cyborg-x1/Mantis-Microscope-Light/README.md

Mantis-Microscope-Light
=======================

A microscope light for mantis microscopes, includes Schematics, Linux Control Software and AVR Software
