cyborg-x1/Mantis-Microscope-Light/kicad/output.pdf

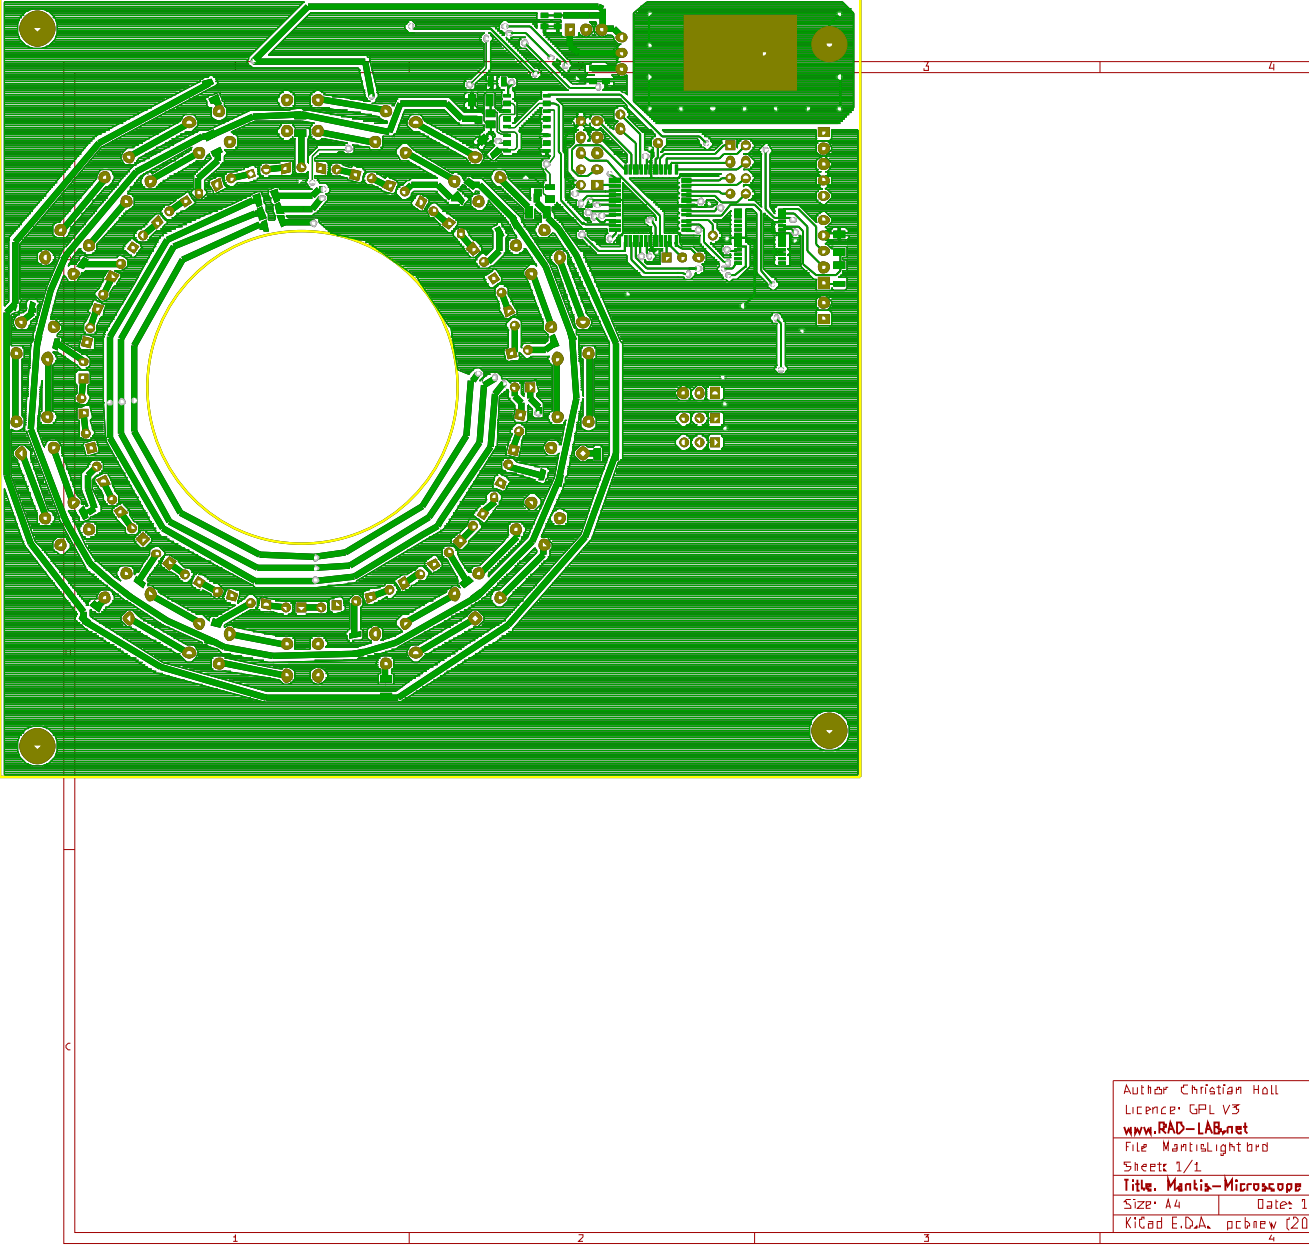
[picture p1: page 1]

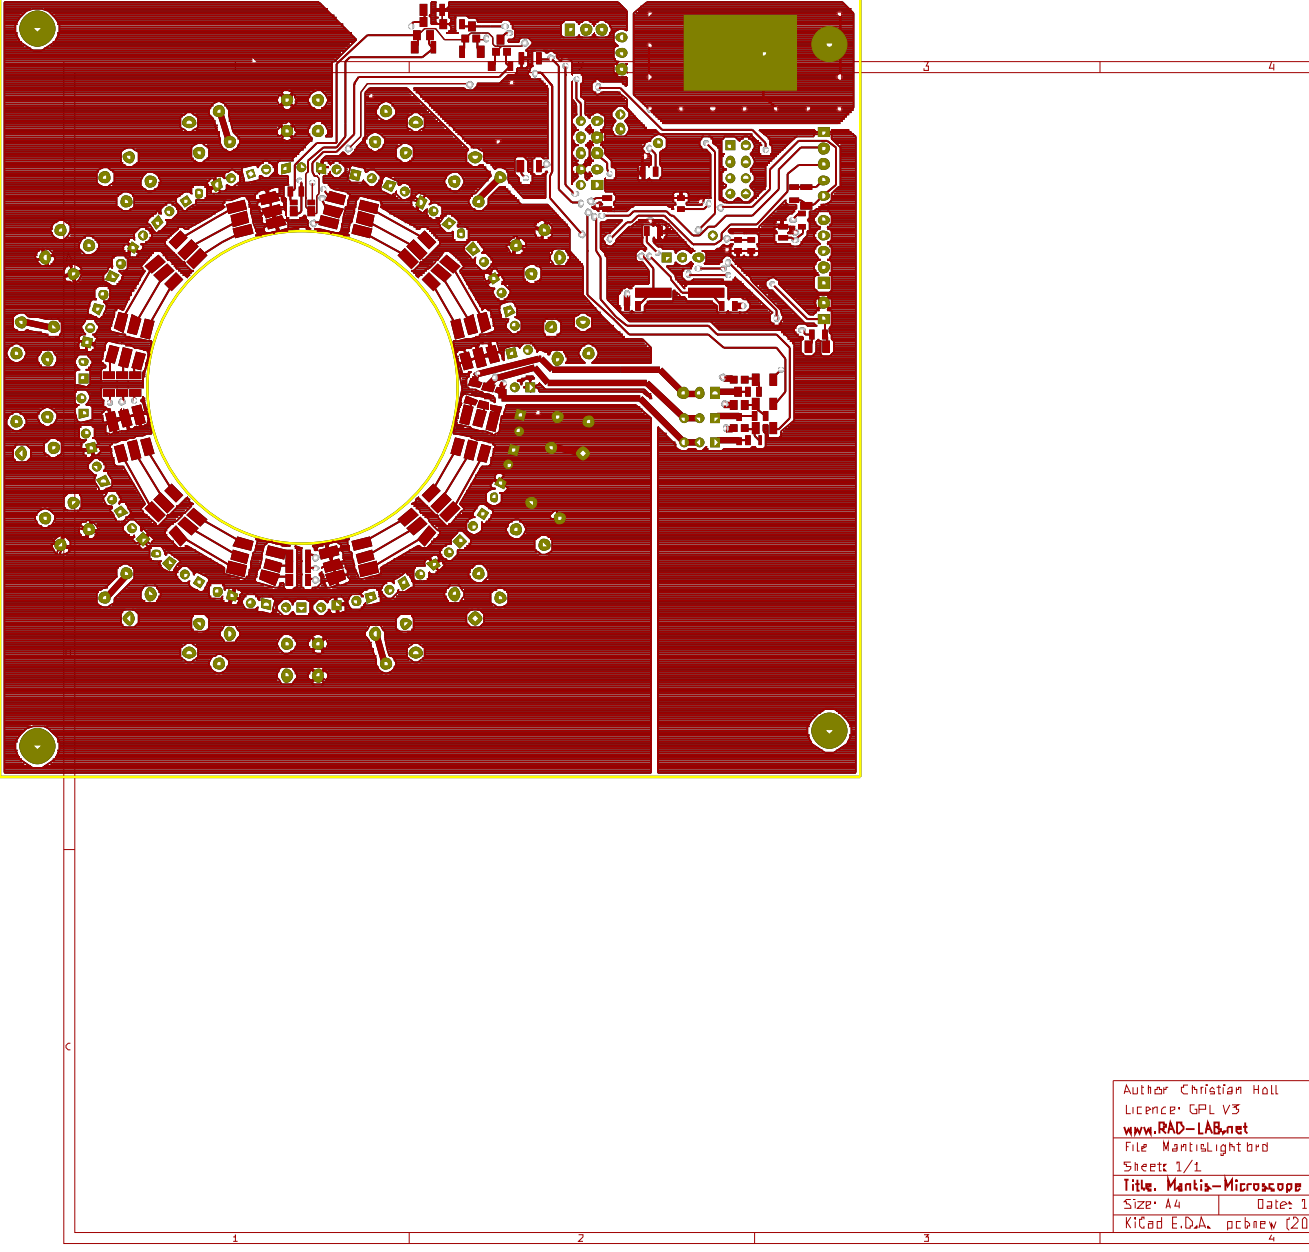
[picture p2: page 2]
