cyborg-x1/Mantis-Microscope-Light/kicad/FT232RL_SelfPowered.sch

## KiCad design kicad/FT232RL_SelfPowered.sch (2014-12-14)

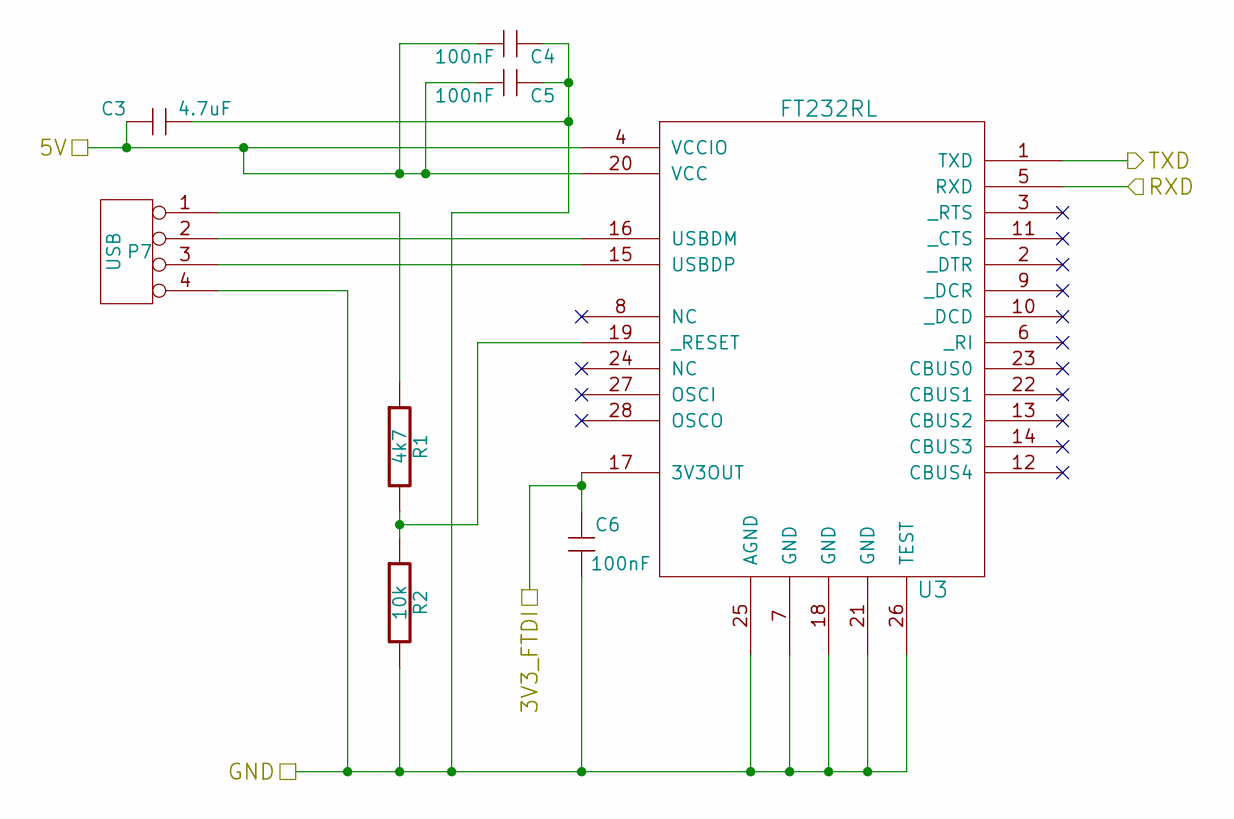
[picture p3: schematic FT232RL_SelfPowered.sch]

Parts:
C3: 4.7uF
C4, C5, C6: 100nF
P7: USB
R1: 4k7
R2: 10k
U3: FT232RL

Connections:
3V3_FTDI: C6.1, U3.17 (3V3OUT)
5V: C3.2, C4.1, C5.1, U3.4 (VCCIO), U3.20 (VCC)
GND: C3.1, C4.2, C5.2, C6.2, P7.4, R2.2, U3.7 (GND), U3.18 (GND), U3.21 (GND), U3.25 (AGND), U3.26 (TEST)
unnamed: P7.1, R1.1
unnamed: P7.2, U3.16 (USBDM)
unnamed: P7.3, U3.15 (USBDP)
unnamed: R1.2, R2.1, U3.19 (_RESET)
RXD: U3.5 (RXD)
TXD: U3.1 (TXD)
