cyborg-x1/Mantis-Microscope-Light/kicad/LEDs.sch

## KiCad design kicad/LEDs.sch (2014-12-29, an earlier design)

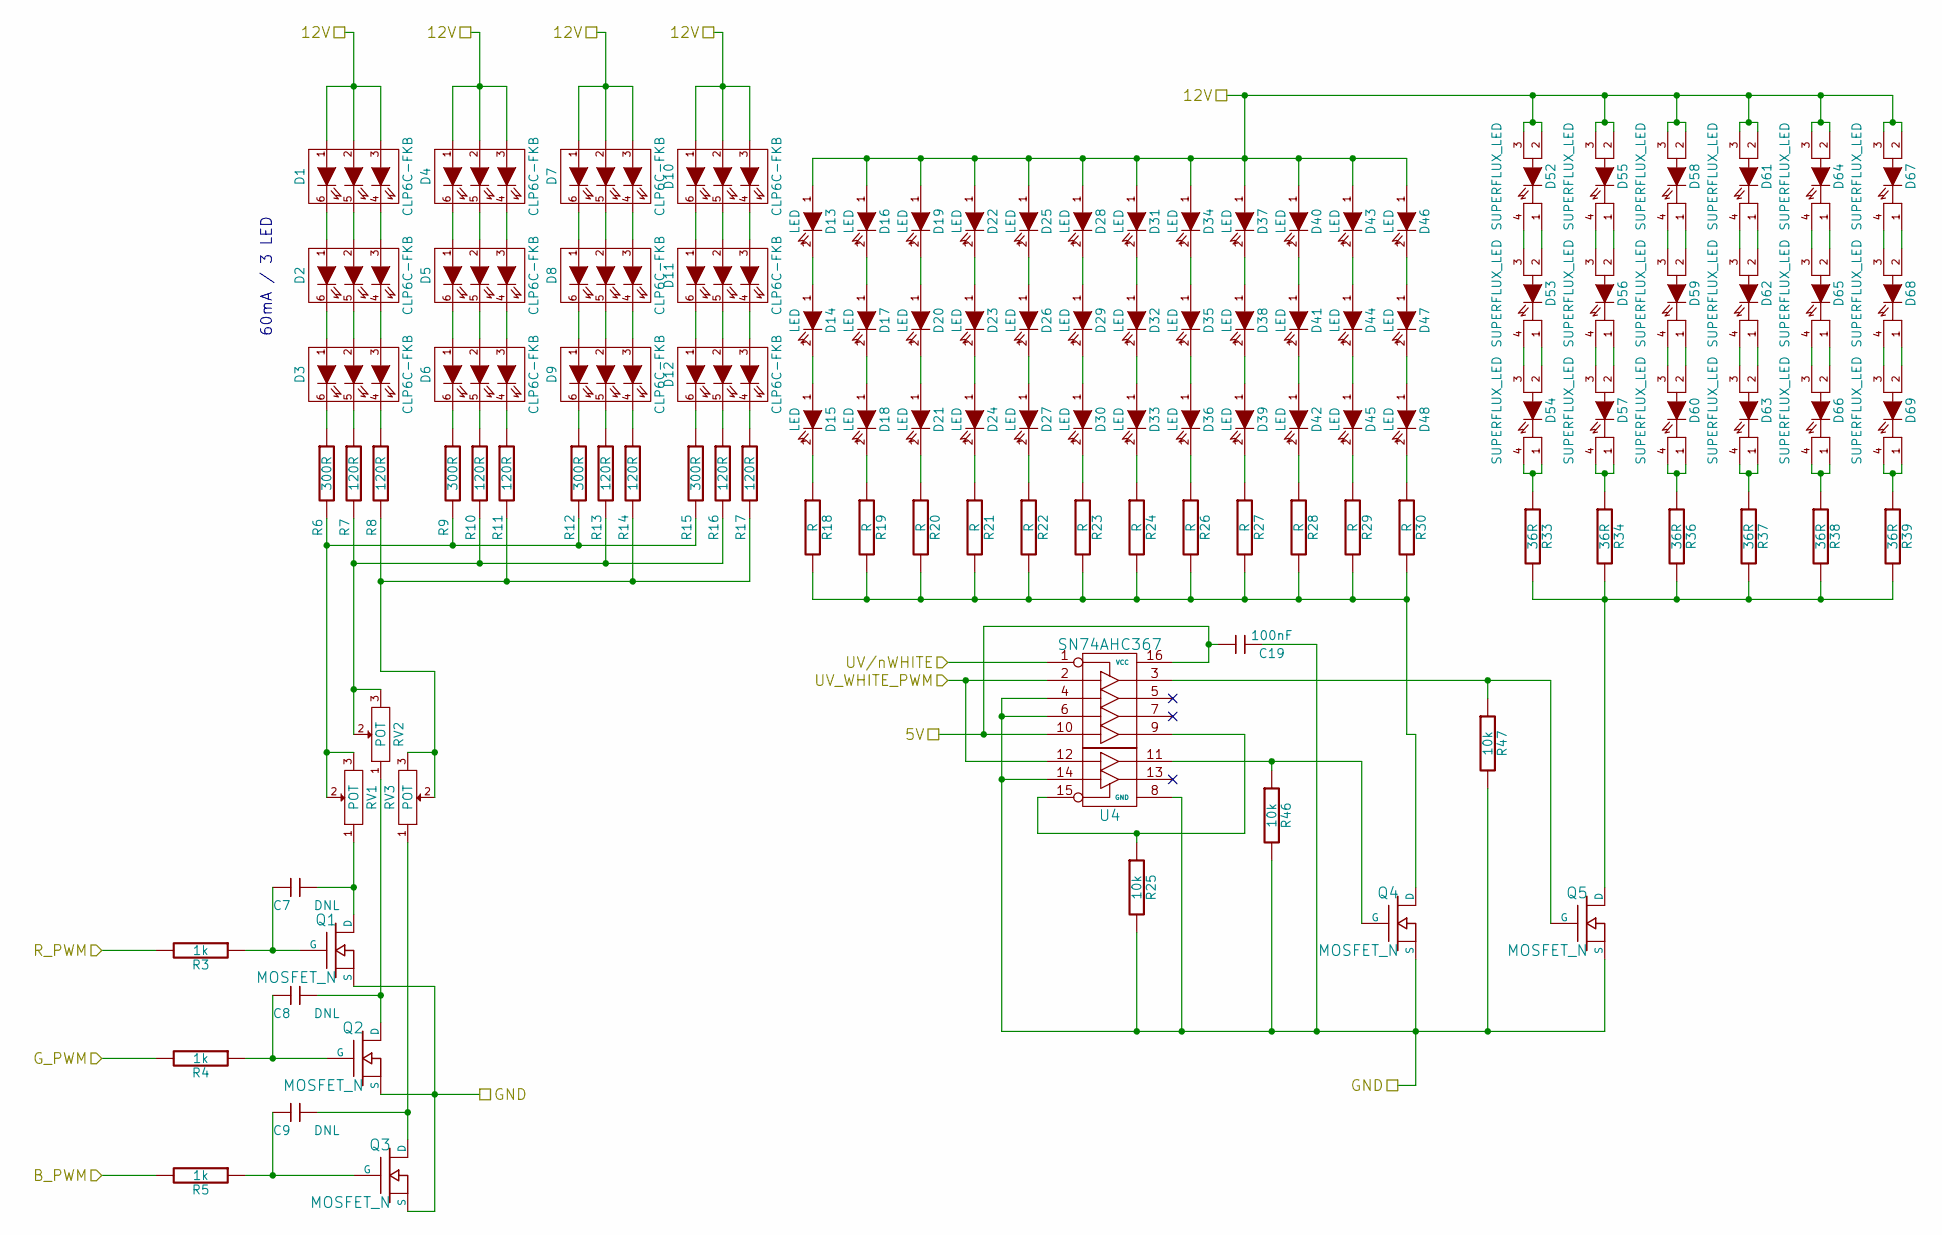
[picture p4: schematic LEDs.sch]

Parts:
C7, C8, C9: DNL
C19: 100nF
D1, D2, D3, D4, D5, D6, D7, D8, D9, D10, D11, D12: CLP6C-FKB
D13, D14, D15, D16, D17, D18, D19, D20, D21, D22, D23, D24, D25, D26, D27, D28, D29, D30, D31, D32, D33, D34, D35, D36, D37, D38, D39, D40, D41, D42, D43, D44, D45, D46, D47, D48: LED
D52, D53, D54, D55, D56, D57, D58, D59, D60, D61, D62, D63, D64, D65, D66, D67, D68, D69: SUPERFLUX_LED
Q1, Q2, Q3, Q4, Q5: MOSFET_N
R3, R4, R5: 1k
R6, R9, R12, R15: 300R
R7, R8, R10, R11, R13, R14, R16, R17: 120R
R18, R19, R20, R21, R22, R23, R24, R26, R27, R28, R29, R30: R
R25, R46, R47: 10k
R33, R34, R36, R37, R38, R39: 36R
RV1, RV2, RV3: POT
U4: SN74AHC367

Connections:
5V: C19.2, U4.10, U4.16 (VCC)
12V: D1.1 (AR), D1.2 (AG), D1.3 (AB), D4.1 (AR), D4.2 (AG), D4.3 (AB), D7.1 (AR), D7.2 (AG), D7.3 (AB), D10.1 (AR), D10.2 (AG), D10.3 (AB), D13.1 (A), D16.1 (A), D19.1 (A), D22.1 (A), D25.1 (A), D28.1 (A), D31.1 (A), D34.1 (A), D37.1 (A), D40.1 (A), D43.1 (A), D46.1 (A), D52.2 (A), D52.3 (A), D55.2 (A), D55.3 (A), D58.2 (A), D58.3 (A), D61.2 (A), D61.3 (A), D64.2 (A), D64.3 (A), D67.2 (A), D67.3 (A)
B_PWM: R5.2
GND: C19.1, Q1.S, Q2.S, Q3.S, Q4.S, Q5.S, R25.2, R46.2, R47.2, U4.4, U4.6, U4.8 (GND), U4.14
G_PWM: R4.2
unnamed: C7.1, Q1.D, RV1.1
unnamed: C7.2, Q1.G, R3.1
unnamed: C8.1, Q2.D, RV2.1
unnamed: C8.2, Q2.G, R4.1
unnamed: C9.1, Q3.D, RV3.1
unnamed: C9.2, Q3.G, R5.1
unnamed: D1.4 (CB), D2.3 (AB)
unnamed: D1.5 (CG), D2.2 (AG)
unnamed: D1.6 (CR), D2.1 (AR)
unnamed: D2.4 (CB), D3.3 (AB)
unnamed: D2.5 (CG), D3.2 (AG)
unnamed: D2.6 (CR), D3.1 (AR)
unnamed: D3.4 (CB), R8.1
unnamed: D3.5 (CG), R7.1
unnamed: D3.6 (CR), R6.1
unnamed: D4.4 (CB), D5.3 (AB)
unnamed: D4.5 (CG), D5.2 (AG)
unnamed: D4.6 (CR), D5.1 (AR)
unnamed: D5.4 (CB), D6.3 (AB)
unnamed: D5.5 (CG), D6.2 (AG)
unnamed: D5.6 (CR), D6.1 (AR)
unnamed: D6.4 (CB), R11.1
unnamed: D6.5 (CG), R10.1
unnamed: D6.6 (CR), R9.1
unnamed: D7.4 (CB), D8.3 (AB)
unnamed: D7.5 (CG), D8.2 (AG)
unnamed: D7.6 (CR), D8.1 (AR)
unnamed: D8.4 (CB), D9.3 (AB)
unnamed: D8.5 (CG), D9.2 (AG)
unnamed: D8.6 (CR), D9.1 (AR)
unnamed: D9.4 (CB), R14.1
unnamed: D9.5 (CG), R13.1
unnamed: D9.6 (CR), R12.1
unnamed: D10.4 (CB), D11.3 (AB)
unnamed: D10.5 (CG), D11.2 (AG)
unnamed: D10.6 (CR), D11.1 (AR)
unnamed: D11.4 (CB), D12.3 (AB)
unnamed: D11.5 (CG), D12.2 (AG)
unnamed: D11.6 (CR), D12.1 (AR)
unnamed: D12.4 (CB), R17.1
unnamed: D12.5 (CG), R16.1
unnamed: D12.6 (CR), R15.1
unnamed: D13.2 (K), D14.1 (A)
unnamed: D14.2 (K), D15.1 (A)
unnamed: D15.2 (K), R18.1
unnamed: D16.2 (K), D17.1 (A)
unnamed: D17.2 (K), D18.1 (A)
unnamed: D18.2 (K), R19.1
unnamed: D19.2 (K), D20.1 (A)
unnamed: D20.2 (K), D21.1 (A)
unnamed: D21.2 (K), R20.1
unnamed: D22.2 (K), D23.1 (A)
unnamed: D23.2 (K), D24.1 (A)
unnamed: D24.2 (K), R21.1
unnamed: D25.2 (K), D26.1 (A)
unnamed: D26.2 (K), D27.1 (A)
unnamed: D27.2 (K), R22.1
unnamed: D28.2 (K), D29.1 (A)
unnamed: D29.2 (K), D30.1 (A)
unnamed: D30.2 (K), R23.1
unnamed: D31.2 (K), D32.1 (A)
unnamed: D32.2 (K), D33.1 (A)
unnamed: D33.2 (K), R24.1
unnamed: D34.2 (K), D35.1 (A)
unnamed: D35.2 (K), D36.1 (A)
unnamed: D36.2 (K), R26.1
unnamed: D37.2 (K), D38.1 (A)
unnamed: D38.2 (K), D39.1 (A)
unnamed: D39.2 (K), R27.1
unnamed: D40.2 (K), D41.1 (A)
unnamed: D41.2 (K), D42.1 (A)
unnamed: D42.2 (K), R28.1
unnamed: D43.2 (K), D44.1 (A)
unnamed: D44.2 (K), D45.1 (A)
unnamed: D45.2 (K), R29.1
unnamed: D46.2 (K), D47.1 (A)
unnamed: D47.2 (K), D48.1 (A)
unnamed: D48.2 (K), R30.1
unnamed: D52.1 (K), D53.2 (A)
unnamed: D52.4 (K), D53.3 (A)
unnamed: D53.1 (K), D54.2 (A)
unnamed: D53.4 (K), D54.3 (A)
unnamed: D54.1 (K), D54.4 (K), R33.1
unnamed: D55.1 (K), D56.2 (A)
unnamed: D55.4 (K), D56.3 (A)
unnamed: D56.1 (K), D57.2 (A)
unnamed: D56.4 (K), D57.3 (A)
unnamed: D57.1 (K), D57.4 (K), R34.1
unnamed: D58.1 (K), D59.2 (A)
unnamed: D58.4 (K), D59.3 (A)
unnamed: D59.1 (K), D60.2 (A)
unnamed: D59.4 (K), D60.3 (A)
unnamed: D60.1 (K), D60.4 (K), R36.1
unnamed: D61.1 (K), D62.2 (A)
unnamed: D61.4 (K), D62.3 (A)
unnamed: D62.1 (K), D63.2 (A)
unnamed: D62.4 (K), D63.3 (A)
unnamed: D63.1 (K), D63.4 (K), R37.1
unnamed: D64.1 (K), D65.2 (A)
unnamed: D64.4 (K), D65.3 (A)
unnamed: D65.1 (K), D66.2 (A)
unnamed: D65.4 (K), D66.3 (A)
unnamed: D66.1 (K), D66.4 (K), R38.1
unnamed: D67.1 (K), D68.2 (A)
unnamed: D67.4 (K), D68.3 (A)
unnamed: D68.1 (K), D69.2 (A)
unnamed: D68.4 (K), D69.3 (A)
unnamed: D69.1 (K), D69.4 (K), R39.1
unnamed: Q4.D, R18.2, R19.2, R20.2, R21.2, R22.2, R23.2, R24.2, R26.2, R27.2, R28.2, R29.2, R30.2
unnamed: Q4.G, R46.1, U4.11
unnamed: Q5.D, R33.2, R34.2, R36.2, R37.2, R38.2, R39.2
unnamed: Q5.G, R47.1, U4.3
unnamed: R7.2, R10.2, R13.2, R16.2, RV2.2, RV2.3
unnamed: R8.2, R11.2, R14.2, R17.2, RV3.2, RV3.3
unnamed: R6.2, R9.2, R12.2, R15.2, RV1.2, RV1.3
unnamed: R25.1, U4.9, U4.15
R_PWM: R3.2
UV/nWHITE: U4.1
UV_WHITE_PWM: U4.2, U4.12

Notes on the sheet:
60mA / 3 LED
