cyborg-x1/Mantis-Microscope-Light/kicad/MantisLight.sch

## KiCad design kicad/MantisLight.sch (2014-12-29, an earlier design)

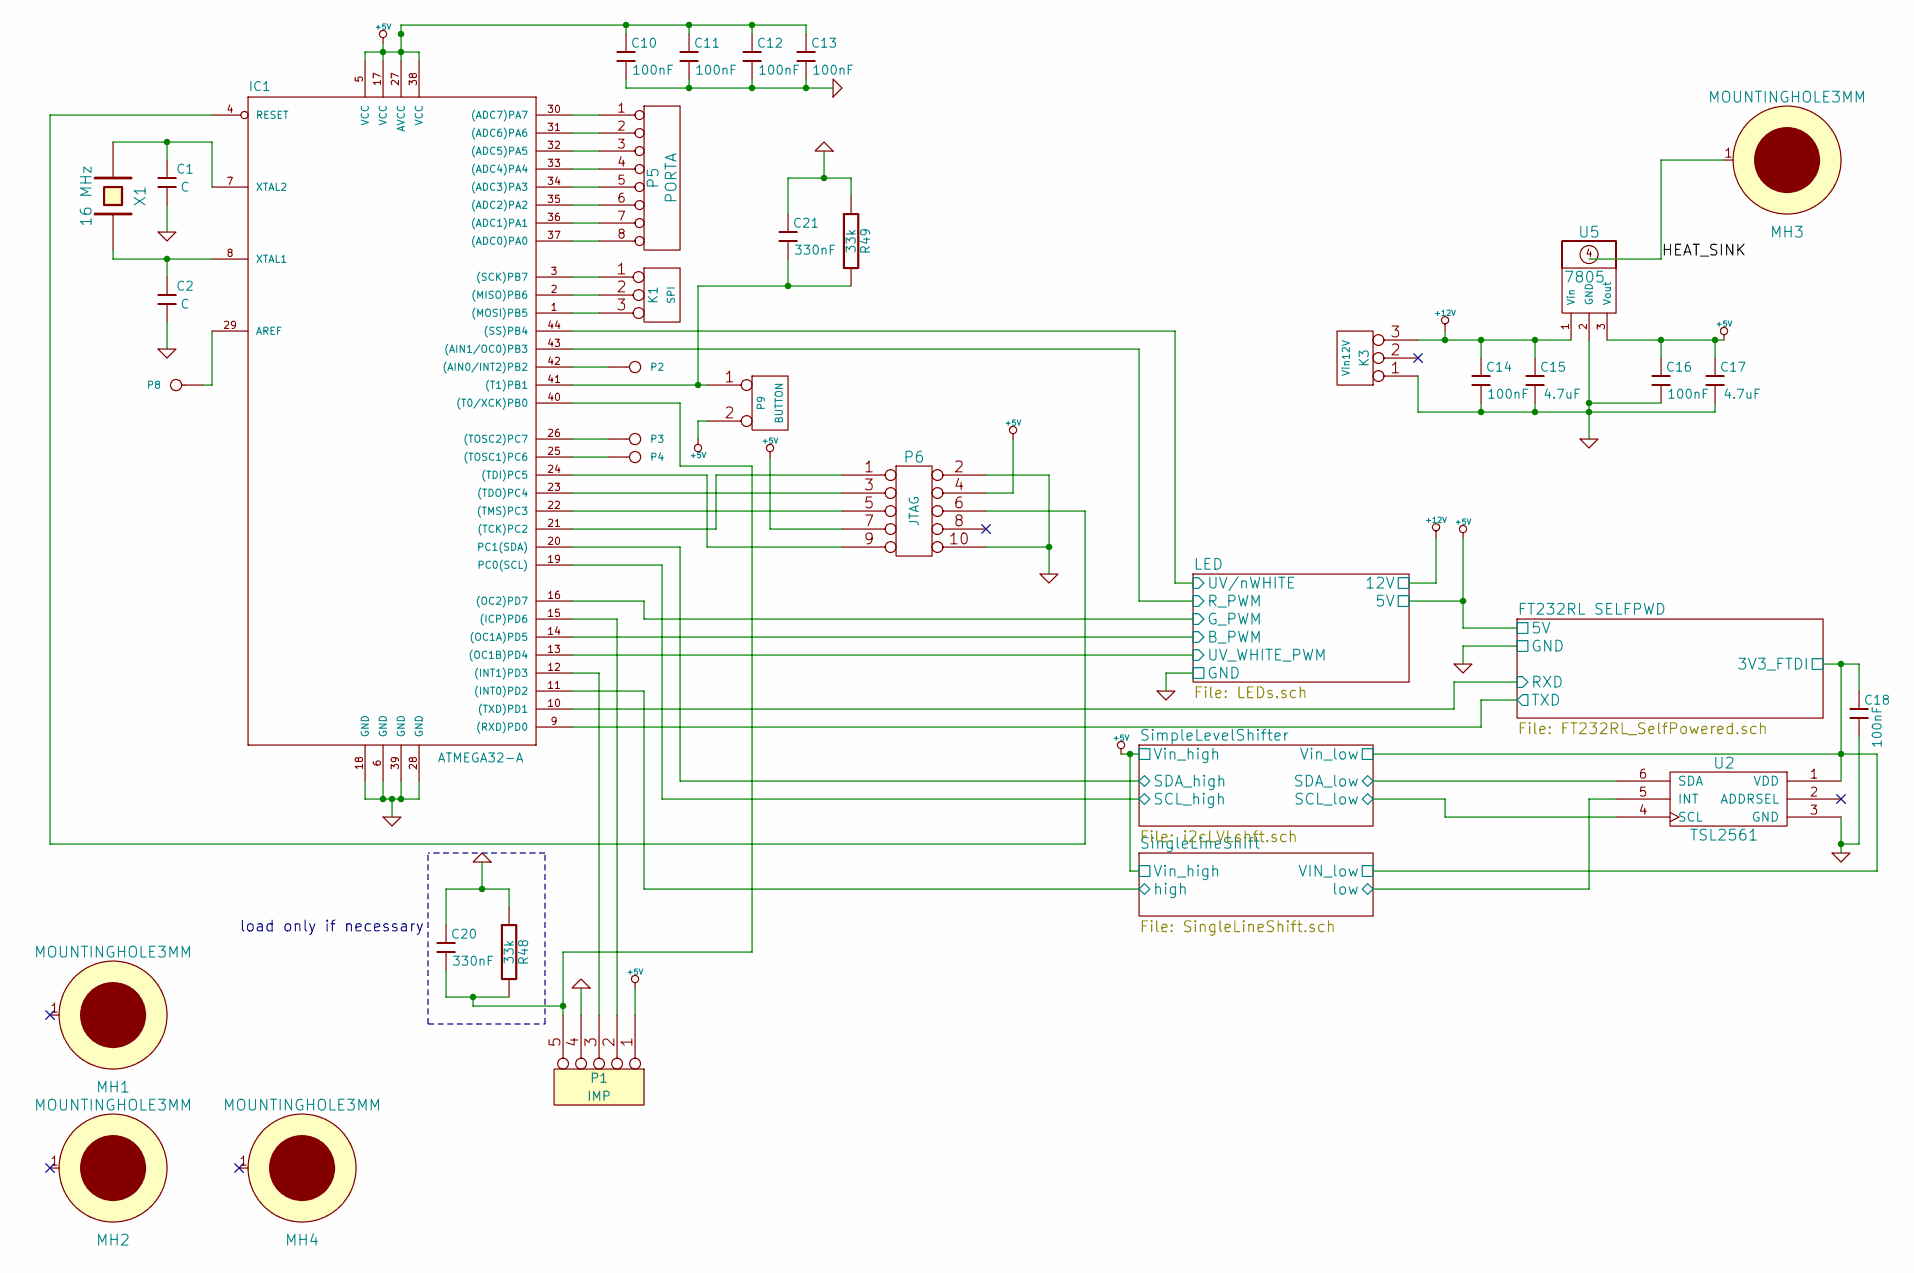
[picture p5: schematic MantisLight.sch]

Parts:
C1, C2: C
C10, C11, C12, C13, C14, C16, C18: 100nF
C15, C17: 4.7uF
C20, C21: 330nF
IC1: ATMEGA32-A; TQFP44
K1: SPI
K3: Vin12V
MH1, MH2, MH3, MH4: MOUNTINGHOLE3MM
P1: IMP
P2: PB2
P3: PC7
P4: PC6
P5: PORTA
P6: JTAG
P8: AREF
P9: BUTTON
R48, R49: 33k
U2: TSL2561
U5: 7805
X1: 16 MHz

Connections:
+5V: C10.1, C11.1, C12.1, C13.1, C16.1, C17.1, IC1.5 (VCC), IC1.17 (VCC), IC1.27 (AVCC), IC1.38 (VCC), P1.1, P6.4, P6.7, P9.2 (PM), U5.3 (Vout)
+12V: C14.1, C15.1, K3.3, U5.1 (Vin)
B_PWM: IC1.14 ((OC1A)PD5)
GND: C1.2, C2.2, C10.2, C11.2, C12.2, C13.2, C14.2, C15.2, C16.2, C17.2, C18.2, C20.1, C21.1, IC1.6 (GND), IC1.18 (GND), IC1.28 (GND), IC1.39 (GND), K3.1, P1.4, P6.2, P6.10, R48.1, R49.1, U2.3 (GND), U5.2 (GND)
G_PWM: IC1.16 ((OC2)PD7)
HEAT_SINK: MH3.1, U5.4
unnamed: C1.1, IC1.7 (XTAL2), X1.1
unnamed: C2.1, IC1.8 (XTAL1), X1.2
unnamed: C20.2, IC1.40 ((T0/XCK)PB0), P1.5, R48.2
unnamed: C21.2, IC1.41 ((T1)PB1), P9.1, R49.2
unnamed: IC1.1 ((MOSI)PB5), K1.3
unnamed: IC1.2 ((MISO)PB6), K1.2 (PM)
unnamed: IC1.3 ((SCK)PB7), K1.1
unnamed: IC1.4 (RESET), P6.6
unnamed: IC1.12 ((INT1)PD3), P1.3
unnamed: IC1.15 ((ICP)PD6), P1.2
unnamed: IC1.21 ((TCK)PC2), P6.1
unnamed: IC1.22 ((TMS)PC3), P6.5
unnamed: IC1.23 ((TDO)PC4), P6.3
unnamed: IC1.24 ((TDI)PC5), P6.9
unnamed: IC1.25 ((TOSC1)PC6), P4.1
unnamed: IC1.26 ((TOSC2)PC7), P3.1
unnamed: IC1.29 (AREF), P8.1
unnamed: IC1.30 ((ADC7)PA7), P5.1
unnamed: IC1.31 ((ADC6)PA6), P5.2
unnamed: IC1.32 ((ADC5)PA5), P5.3
unnamed: IC1.33 ((ADC4)PA4), P5.4
unnamed: IC1.34 ((ADC3)PA3), P5.5
unnamed: IC1.35 ((ADC2)PA2), P5.6
unnamed: IC1.36 ((ADC1)PA1), P5.7
unnamed: IC1.37 ((ADC0)PA0), P5.8
unnamed: IC1.42 ((AIN0/INT2)PB2), P2.1
RXD: IC1.10 ((TXD)PD1)
R_PWM: IC1.43 ((AIN1/OC0)PB3)
SCL_high: IC1.19 (PC0(SCL))
SCL_low: U2.4 (SCL)
SDA_high: IC1.20 (PC1(SDA))
SDA_low: U2.6 (SDA)
TXD: IC1.9 ((RXD)PD0)
UV/nWHITE: IC1.44 ((SS)PB4)
UV_WHITE_PWM: IC1.13 ((OC1B)PD4)
VIN_low: C18.1, U2.1 (VDD)
high: IC1.11 ((INT0)PD2)
low: U2.5 (INT)

Notes on the sheet:
load only if necessary
