cyborg-x1/Mantis-Microscope-Light/kicad/SingleLineShift.sch

## KiCad design kicad/SingleLineShift.sch (2014-12-29, an earlier design)

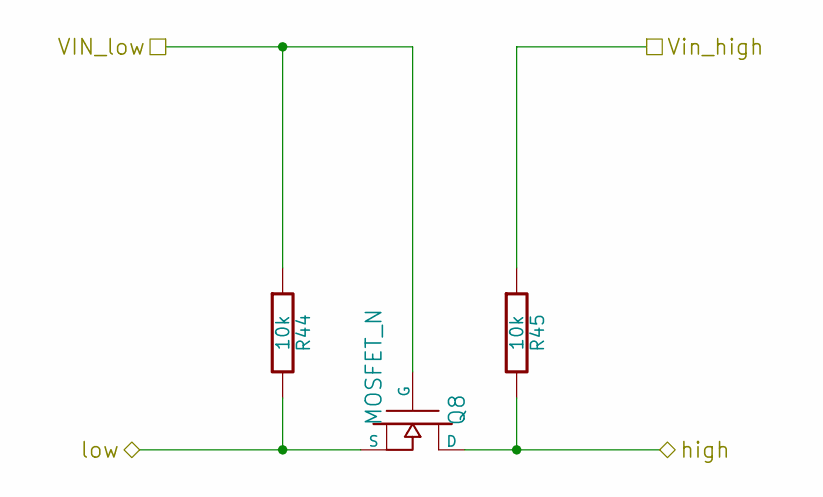
[picture p6: schematic SingleLineShift.sch]

Parts:
Q8: MOSFET_N
R44, R45: 10k

Connections:
VIN_low: Q8.G, R44.1
Vin_high: R45.1
high: Q8.D, R45.2
low: Q8.S, R44.2
