cyborg-x1/Mantis-Microscope-Light/kicad/i2cLVLshft.sch

## KiCad design kicad/i2cLVLshft.sch (2014-12-29, an earlier design)

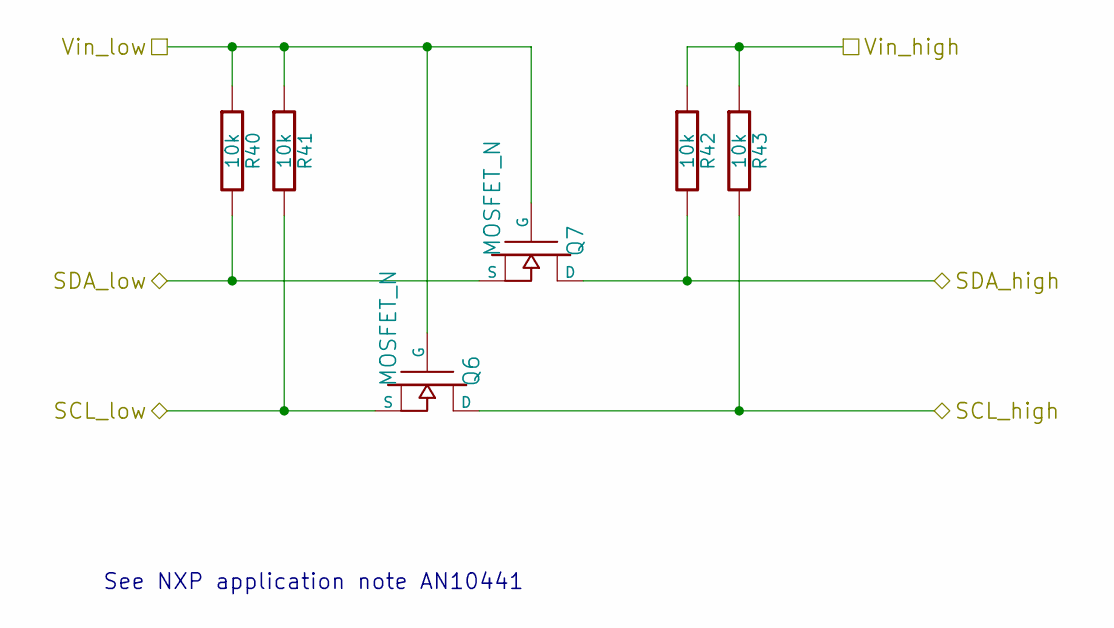
[picture p7: schematic i2cLVLshft.sch]

Parts:
Q6, Q7: MOSFET_N
R40, R41, R42, R43: 10k

Connections:
SCL_high: Q6.D, R43.2
SCL_low: Q6.S, R41.2
SDA_high: Q7.D, R42.2
SDA_low: Q7.S, R40.2
Vin_high: R42.1, R43.1
Vin_low: Q6.G, Q7.G, R40.1, R41.1

Notes on the sheet:
See NXP application note AN10441
