cyborg-x1/Mantis-Microscope-Light/(commit log)

2014-12-14 Kicad merge
    [$savepcb.brd, FT232RL_SelfPowered.sch, LEDs.sch, MantisLight.brd, MantisLight.csv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]
2014-12-14 Setting up strings for connection GUI and preparation for product string filter
2014-12-29 New protocol for LED update
2014-12-29 fix in Schematic which did not fit the layout
    JTAG Connector wiring in Schematic was wrong.
    (How the hell did that happen?
    Guess: Tried to "Clean" the wiring in Schematics but did not update netlist)
    [LEDs.sch, MantisLight.sch, SingleLineShift.sch, i2cLVLshft.sch]
2014-12-29 Add comment for checksum error message
    [color.c]
2014-12-29 add updateLED commands to button click handler
2014-12-29 add library try to fix the port issue
    [color.c, main.c]
2014-12-29 update leds on connect
