cyborg-x1/Mantis-Microscope-Light/(notices)

Notices in the files:
kicad/$savepcb.brd:
Licence: GPL V3
